rointep/SFPzilla/SFPzilla_DOKUMENTACIJA/konektor za SFP.pdf

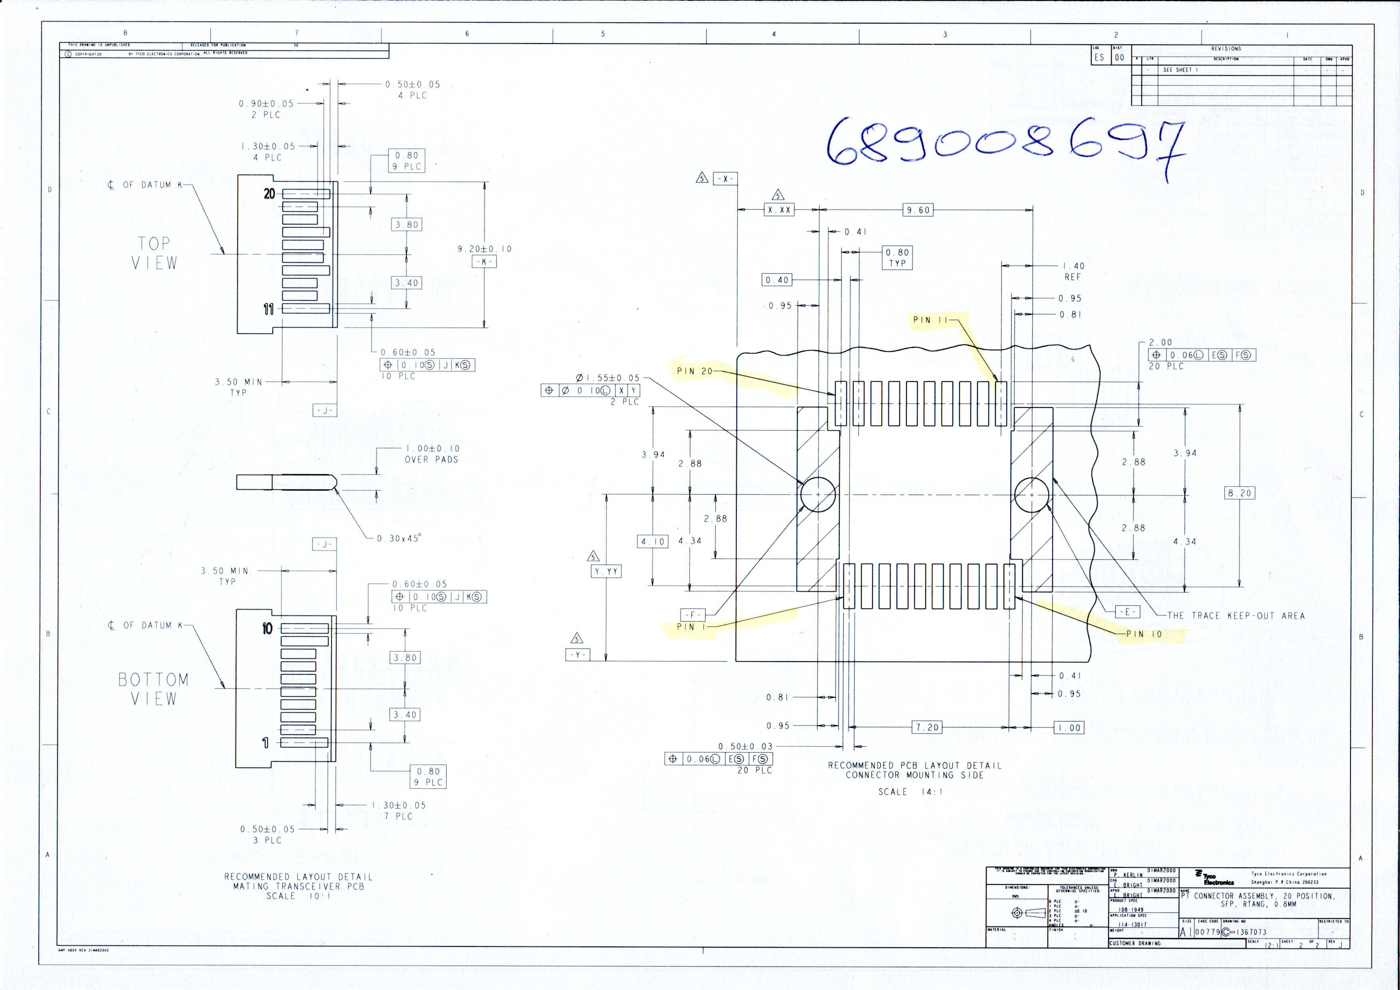
[picture p9: page 1]
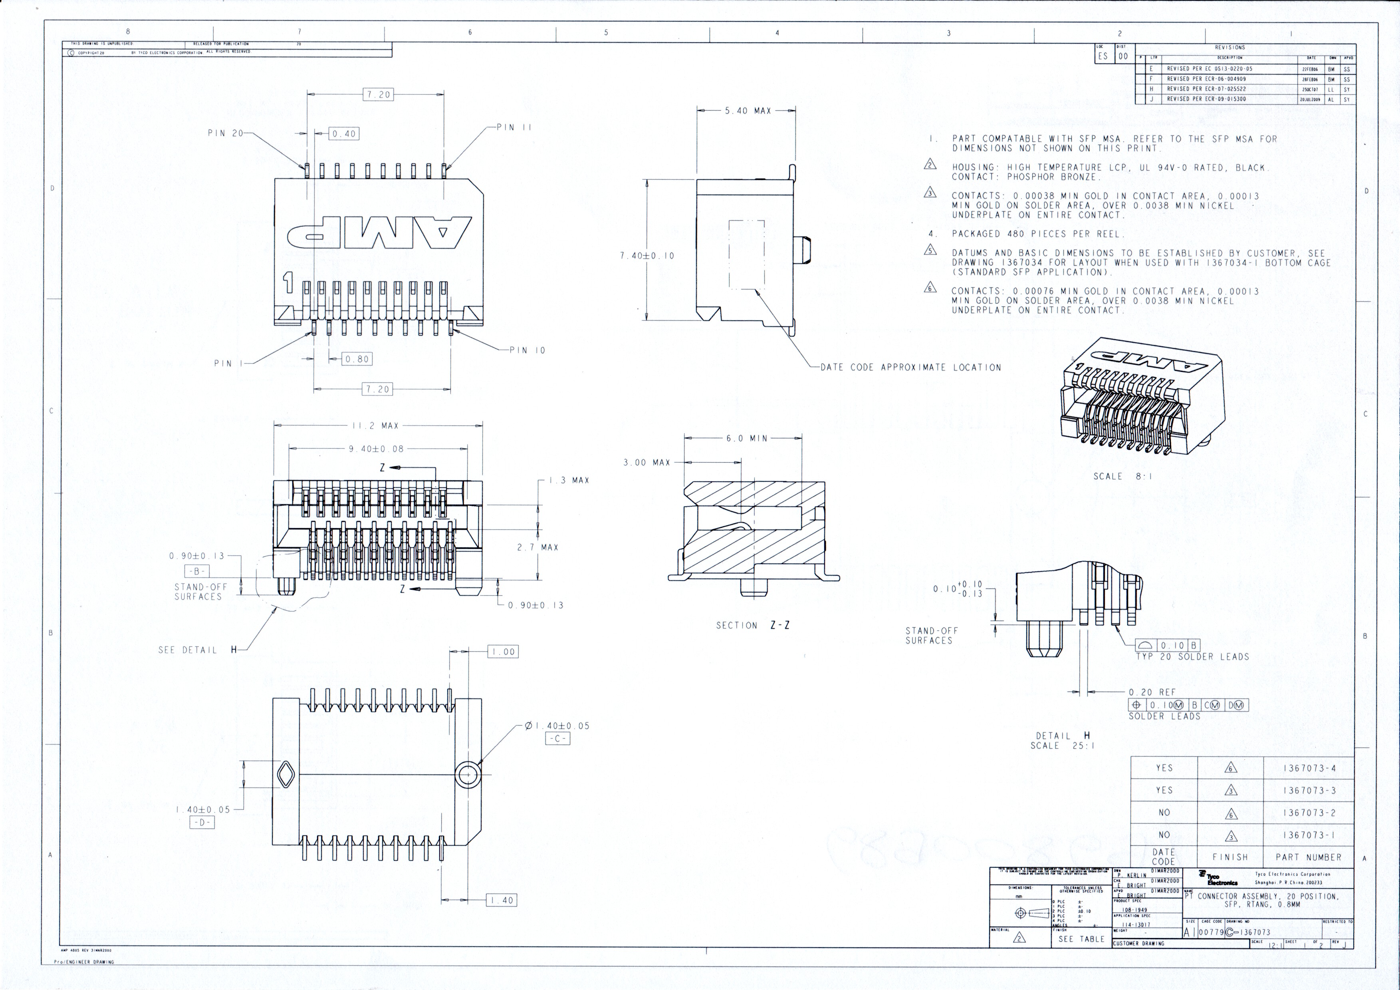
[picture p10: page 2]
