rointep/SFPzilla/SFPzilla_VS/SFPzilla/Resources/download1.png

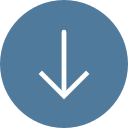
SFPzilla_VS/SFPzilla/Resources/download1.png
