rointep/SFPzilla/SFPzilla_VS/SFPzilla/Resources/less.png

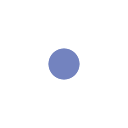
SFPzilla_VS/SFPzilla/Resources/less.png
