rointep/SFPzilla/SFPzilla_VS/SFPzilla/Resources/SFPzilla.png

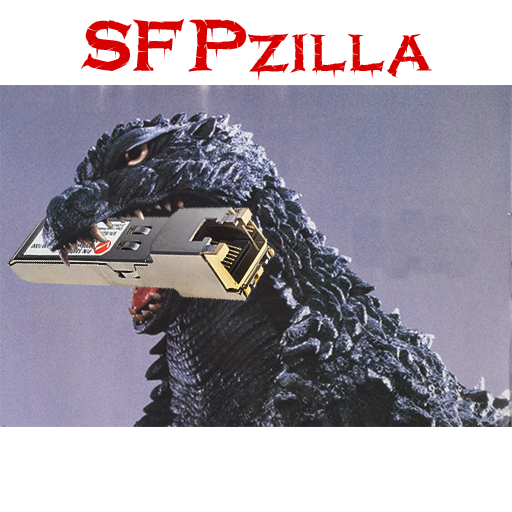
SFPzilla_VS/SFPzilla/Resources/SFPzilla.png
