rointep/SFPzilla/(commit log)

2017-02-22 zaradi releja namesto tranzistorja za vklop napajanja SFP modula sem moral spremeniti polariteto kontrolnega signala na pin-u 12.
2017-06-28 implementirani read16 in write16 komandi: 16bitni dostop do i2c naprave. To sem delal za dostop do phy na Copper SFP modulu. Testiran je bil dostop do Marvell 88E1111 phy.
